Ma-Phil/SuperUAV-tutorial/docs/assets/main/propeller-7x4x3.png

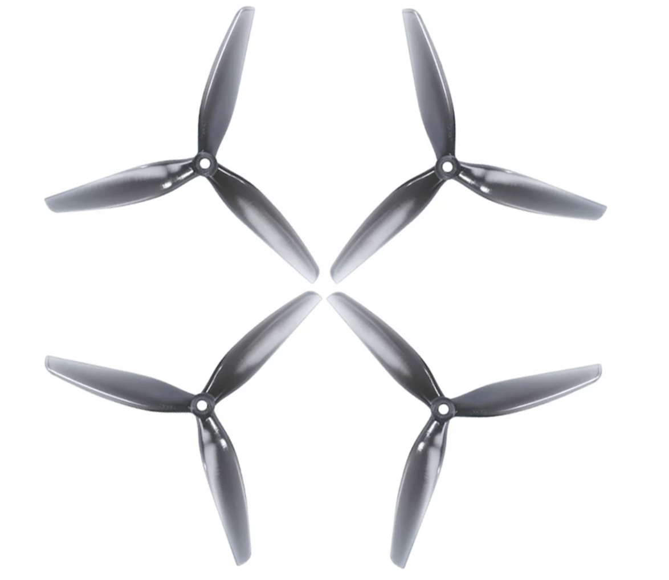
docs/assets/main/propeller-7x4x3.png
