Ma-Phil/SuperUAV-tutorial/docs/assets/models/realsense-mount/Super_Camera_40mm.STP

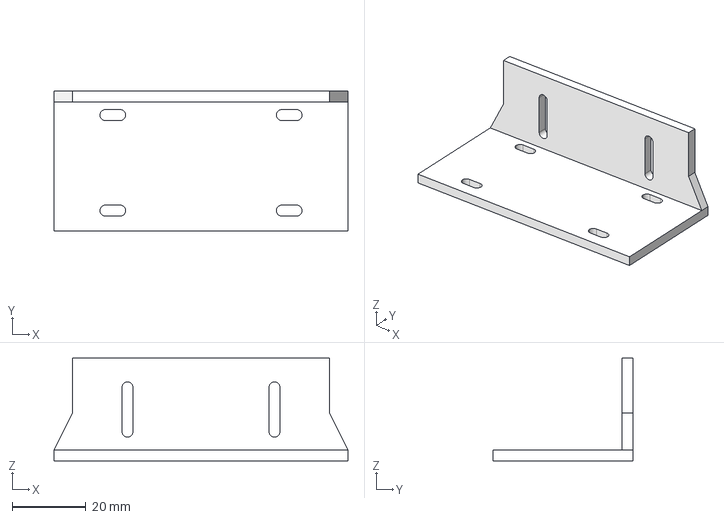
[picture p14: CAD file, 2026-09-05]
docs/assets/models/realsense-mount/Super_Camera_40mm.STP
80.0 x 38.0 x 28.0 mm
