Ma-Phil/SuperUAV-tutorial/docs/assets/diagrams/hardware-wiring.html

# 硬件连线总览

按支路查看 XT60 主电源、电调、电机、降压模块、PIX6C MINI 飞控、雷达 / NUC 线束和遥控接收器之间的连接关系。

6S 电池

6S 电池 / XT60说明

19V 降压

19V 降压说明

雷达 NUC 供电与网口线材

雷达 / NUC 线材说明

雷达与 NUC占位

由 19V 支路供电；具体 NUC 系统和网络配置放到第三部分。

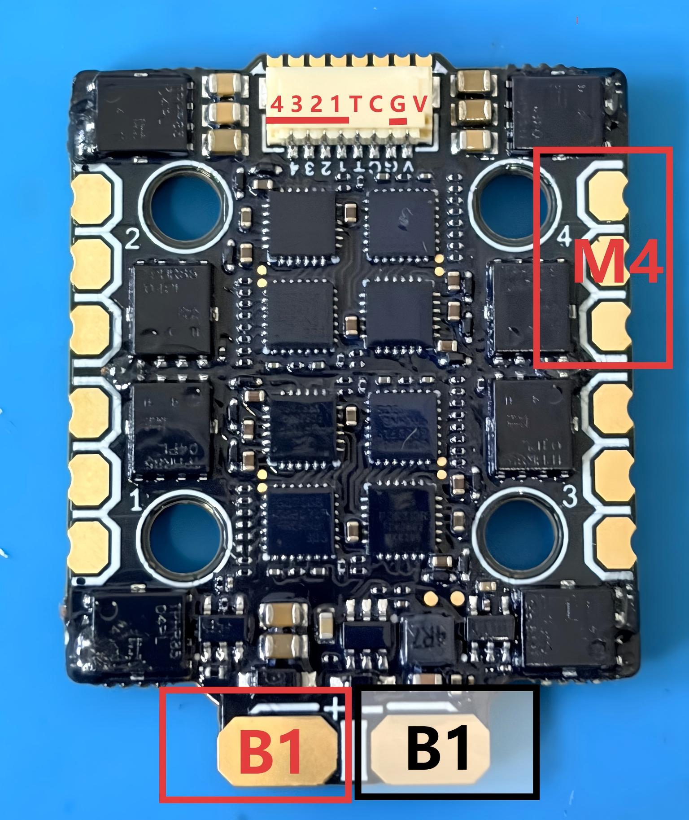
[picture p15: docs/assets/main/esc-f60-mini-4in1-v2.jpg]
F60 MINI 4IN1 V2 电调
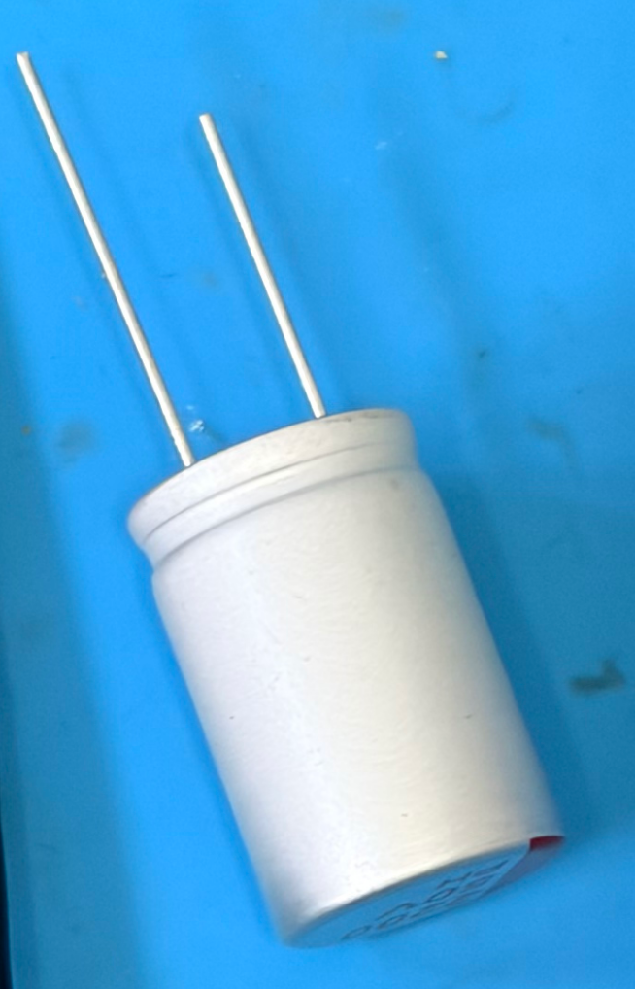
[picture p16: docs/assets/main/capacitor-50v-2200uf.png]
外接 50V 2200uF 电容
 

F60 4IN1 V2 电调 + 外接电容说明

电容并在电调主电源端，本教程使用外接 50V 2200uF 电容。

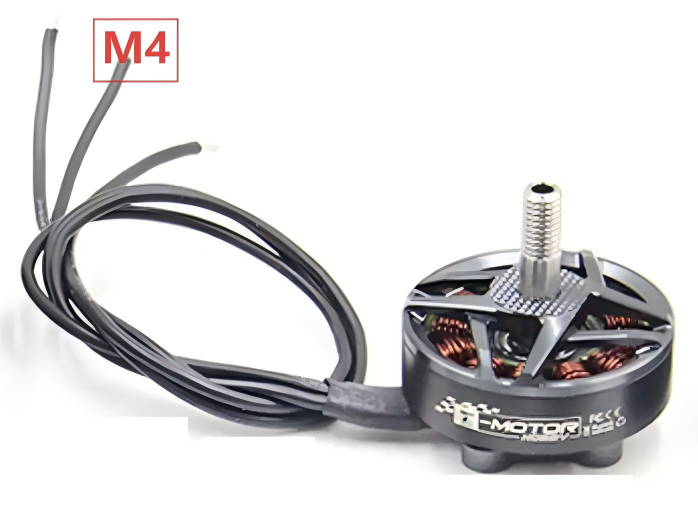
[picture p17: docs/assets/main/motor-f90-kv1300.png]
F90 电机 KV1300


F90 电机 KV1300说明

5V 降压

5V 降压说明

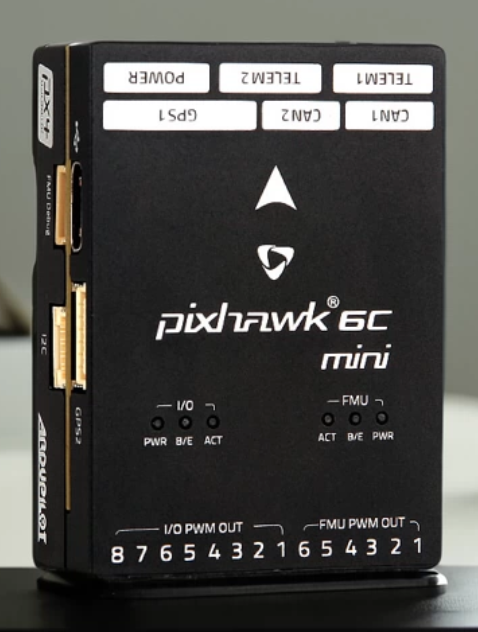
[picture p18: docs/assets/main/flight-controller-pix6c-mini.png]
PIX6C MINI 飞控


PIX6C MINI 飞控说明

遥控接收器说明

接飞控对应接收机接口；协议和校准放到飞控调试部分。

线束图例

红色：正极 / 电源正

黑色：GND / 电源负

橙色：降压输出 / 支路供电

蓝色：电机相线 A

绿色：电机相线 B

棕色：电机相线 C

紫色：电调到飞控控制信号

青色：遥控接收器连接
