Ma-Phil/SuperUAV-tutorial/docs/flight-debug/orbit-autonomous-test.md

# 定点环绕自主飞行测试流程

!!! warning "先通过 EKF Gate"
    定点环绕自主飞行测试流程必须在 EKF Gate 与融合检查通过后再进行。

!!! note "占位"
    内容待定。
