Ma-Phil/SuperUAV-tutorial/docs/assets/params/Super01_Gate15SD.params

1	1	BAT1_A_PER_V	36.367515563964843750	9
1	1	BAT1_CAPACITY	-1.000000000000000000	9
1	1	BAT1_I_CHANNEL	-1	6
1	1	BAT1_N_CELLS	6	6
1	1	BAT1_R_INTERNAL	-1.000000000000000000	9
1	1	BAT1_SOURCE	0	6
1	1	BAT1_V_CHANNEL	-1	6
1	1	BAT1_V_CHARGED	4.050000190734863281	9
1	1	BAT1_V_DIV	18.100000381469726563	9
1	1	BAT1_V_EMPTY	3.500000000000000000	9
1	1	BAT1_V_LOAD_DROP	0.300000011920928955	9
1	1	BAT2_A_PER_V	36.367515563964843750	9
1	1	BAT2_CAPACITY	-1.000000000000000000	9
1	1	BAT2_I_CHANNEL	-1	6
1	1	BAT2_N_CELLS	0	6
1	1	BAT2_R_INTERNAL	-1.000000000000000000	9
1	1	BAT2_SOURCE	-1	6
1	1	BAT2_V_CHANNEL	-1	6
1	1	BAT2_V_CHARGED	4.050000190734863281	9
1	1	BAT2_V_DIV	18.100000381469726563	9
1	1	BAT2_V_EMPTY	3.500000000000000000	9
1	1	BAT2_V_LOAD_DROP	0.300000011920928955	9
1	1	BAT_AVRG_CURRENT	15.000000000000000000	9
1	1	BAT_CRIT_THR	0.070000000298023224	9
1	1	BAT_EMERGEN_THR	0.050000000745058060	9
1	1	BAT_LOW_THR	0.150000005960464478	9
1	1	BAT_N_CELLS	3	6
1	1	BAT_V_CHARGED	4.050000190734863281	9
1	1	BAT_V_EMPTY	3.500000000000000000	9
1	1	BAT_V_LOAD_DROP	0.300000011920928955	9
1	1	BAT_V_OFFS_CURR	0.000000000000000000	9
1	1	MC_PITCHRATE_D	0.004000000189989805	9
1	1	MC_PITCHRATE_FF	0.000000000000000000	9
1	1	MC_PITCHRATE_I	0.090000003576278687	9
1	1	MC_PITCHRATE_K	1.000000000000000000	9
1	1	MC_PITCHRATE_MAX	220.000000000000000000	9
1	1	MC_PITCHRATE_P	0.140000000596046448	9
1	1	MC_PITCH_P	6.000000000000000000	9
1	1	MC_ROLLRATE_D	0.004000000189989805	9
1	1	MC_ROLLRATE_FF	0.000000000000000000	9
1	1	MC_ROLLRATE_I	0.100000001490116119	9
1	1	MC_ROLLRATE_K	1.000000000000000000	9
1	1	MC_ROLLRATE_MAX	220.000000000000000000	9
1	1	MC_ROLLRATE_P	0.140000000596046448	9
1	1	MC_ROLL_P	6.500000000000000000	9
1	1	MC_YAWRATE_D	0.000000000000000000	9
1	1	MC_YAWRATE_FF	0.000000000000000000	9
1	1	MC_YAWRATE_I	0.100000001490116119	9
1	1	MC_YAWRATE_K	1.000000000000000000	9
1	1	MC_YAWRATE_MAX	200.000000000000000000	9
1	1	MC_YAWRATE_P	0.200000002980232239	9
1	1	MC_YAW_P	4.000000000000000000	9
1	1	MC_YAW_WEIGHT	0.400000005960464478	9
1	1	MOT_ORDERING	0	6
1	1	MOT_POLE_COUNT	14	6
1	1	MOT_SLEW_MAX	0.000000000000000000	9
1	1	SYS_AUTOSTART	4031	6
