Ma-Phil/SuperUAV-tutorial/(commit log)

2026-07-05 修改优化
2026-07-05 增加MkDocs源码
2026-07-05 Add params
    [Super01_Gate15SD.params]
2026-07-05 Minimize MkDocs Pages source
    [Super01_Gate15SD.params]
2026-07-05 更新流程图
2026-09-05 添加 Super 飞机与 RealSense D400/T265 相机支架模型和预览图
    保留原始 Super_Camera_40mm.STP 模型，附上支架预览图。用途：Super 飞机与 RealSense D400/T265 相机的支架。
    [Super_Camera_40mm.STP]
2026-09-05 添加 Super 飞机 RealSense D400/T265 相机支架说明与下载入口
2026-09-05 在 RealSense 配置页添加相机支架模型入口
